cmu-argus-1/Avionics-Mainboard/Mainboard.kicad_pcb

## KiCad design Mainboard.kicad_pcb (2024-07-19)

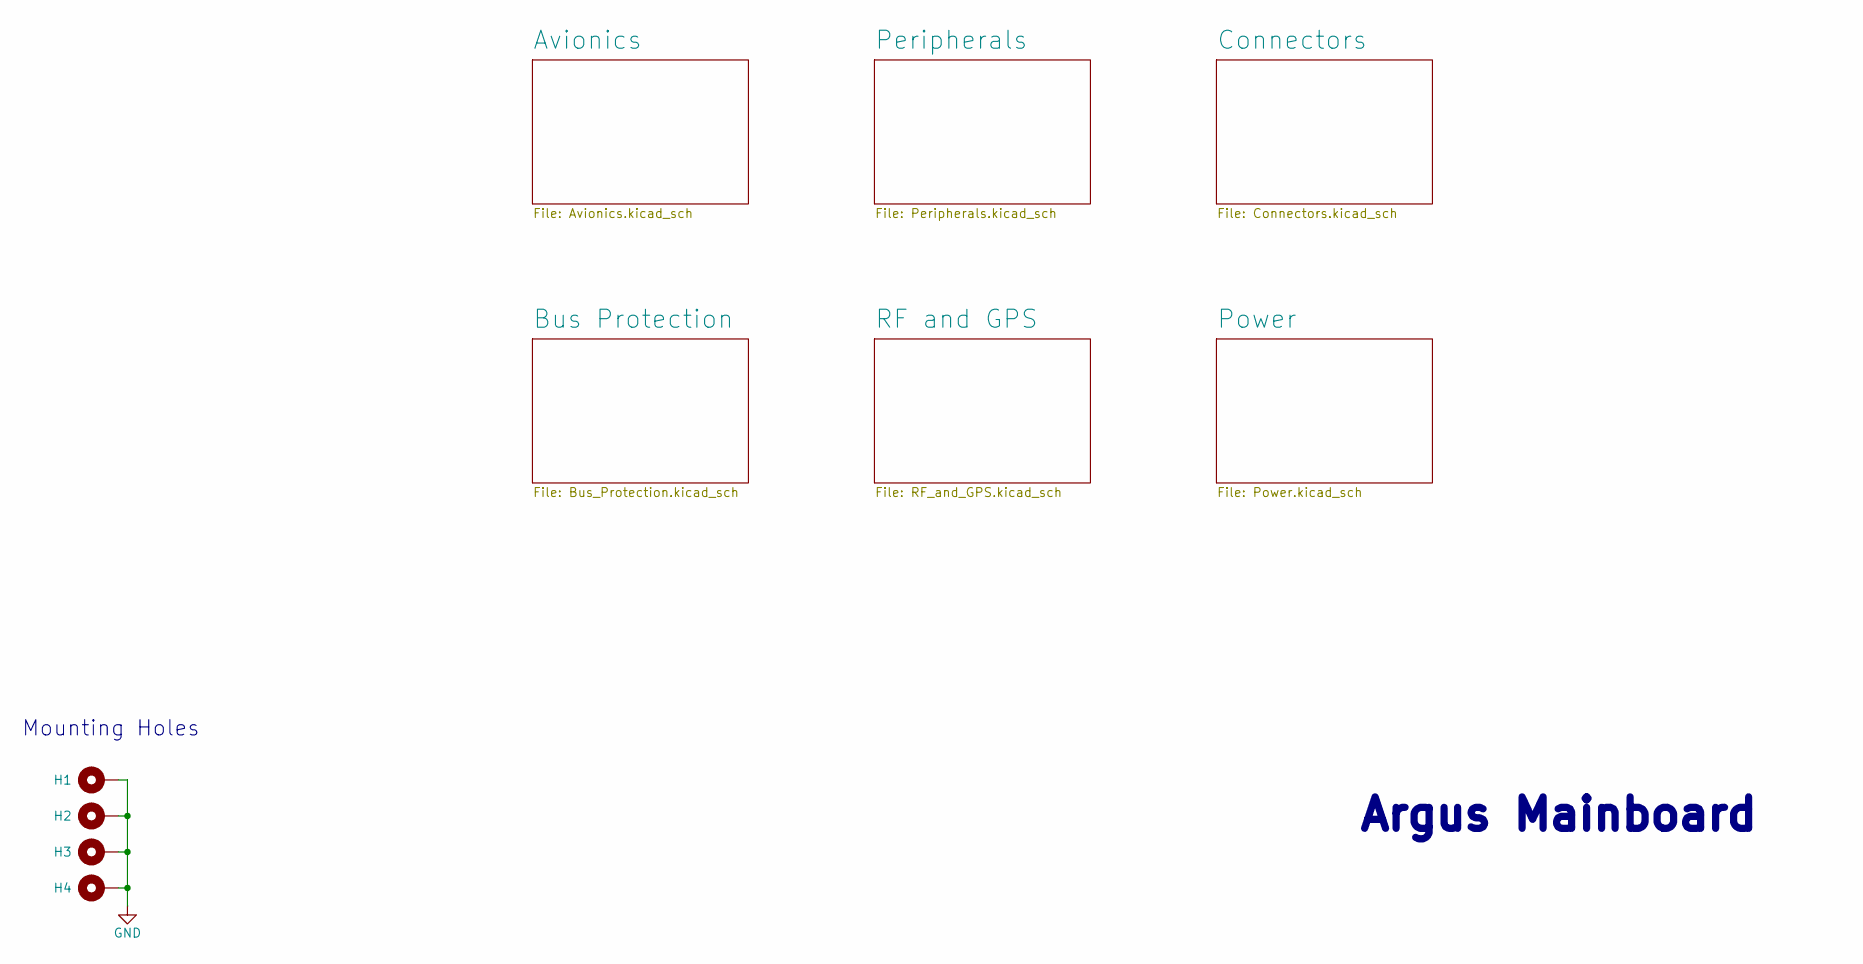
[picture p1: schematic Mainboard.kicad_sch]

Parts:
H1, H2, H3, H4: MountingHole_Pad; MountingHole2

Connections:
GND: H1.1, H2.1, H3.1, H4.1; also elsewhere on the board

Notes on the sheet:
Mounting Holes
Argus Mainboard

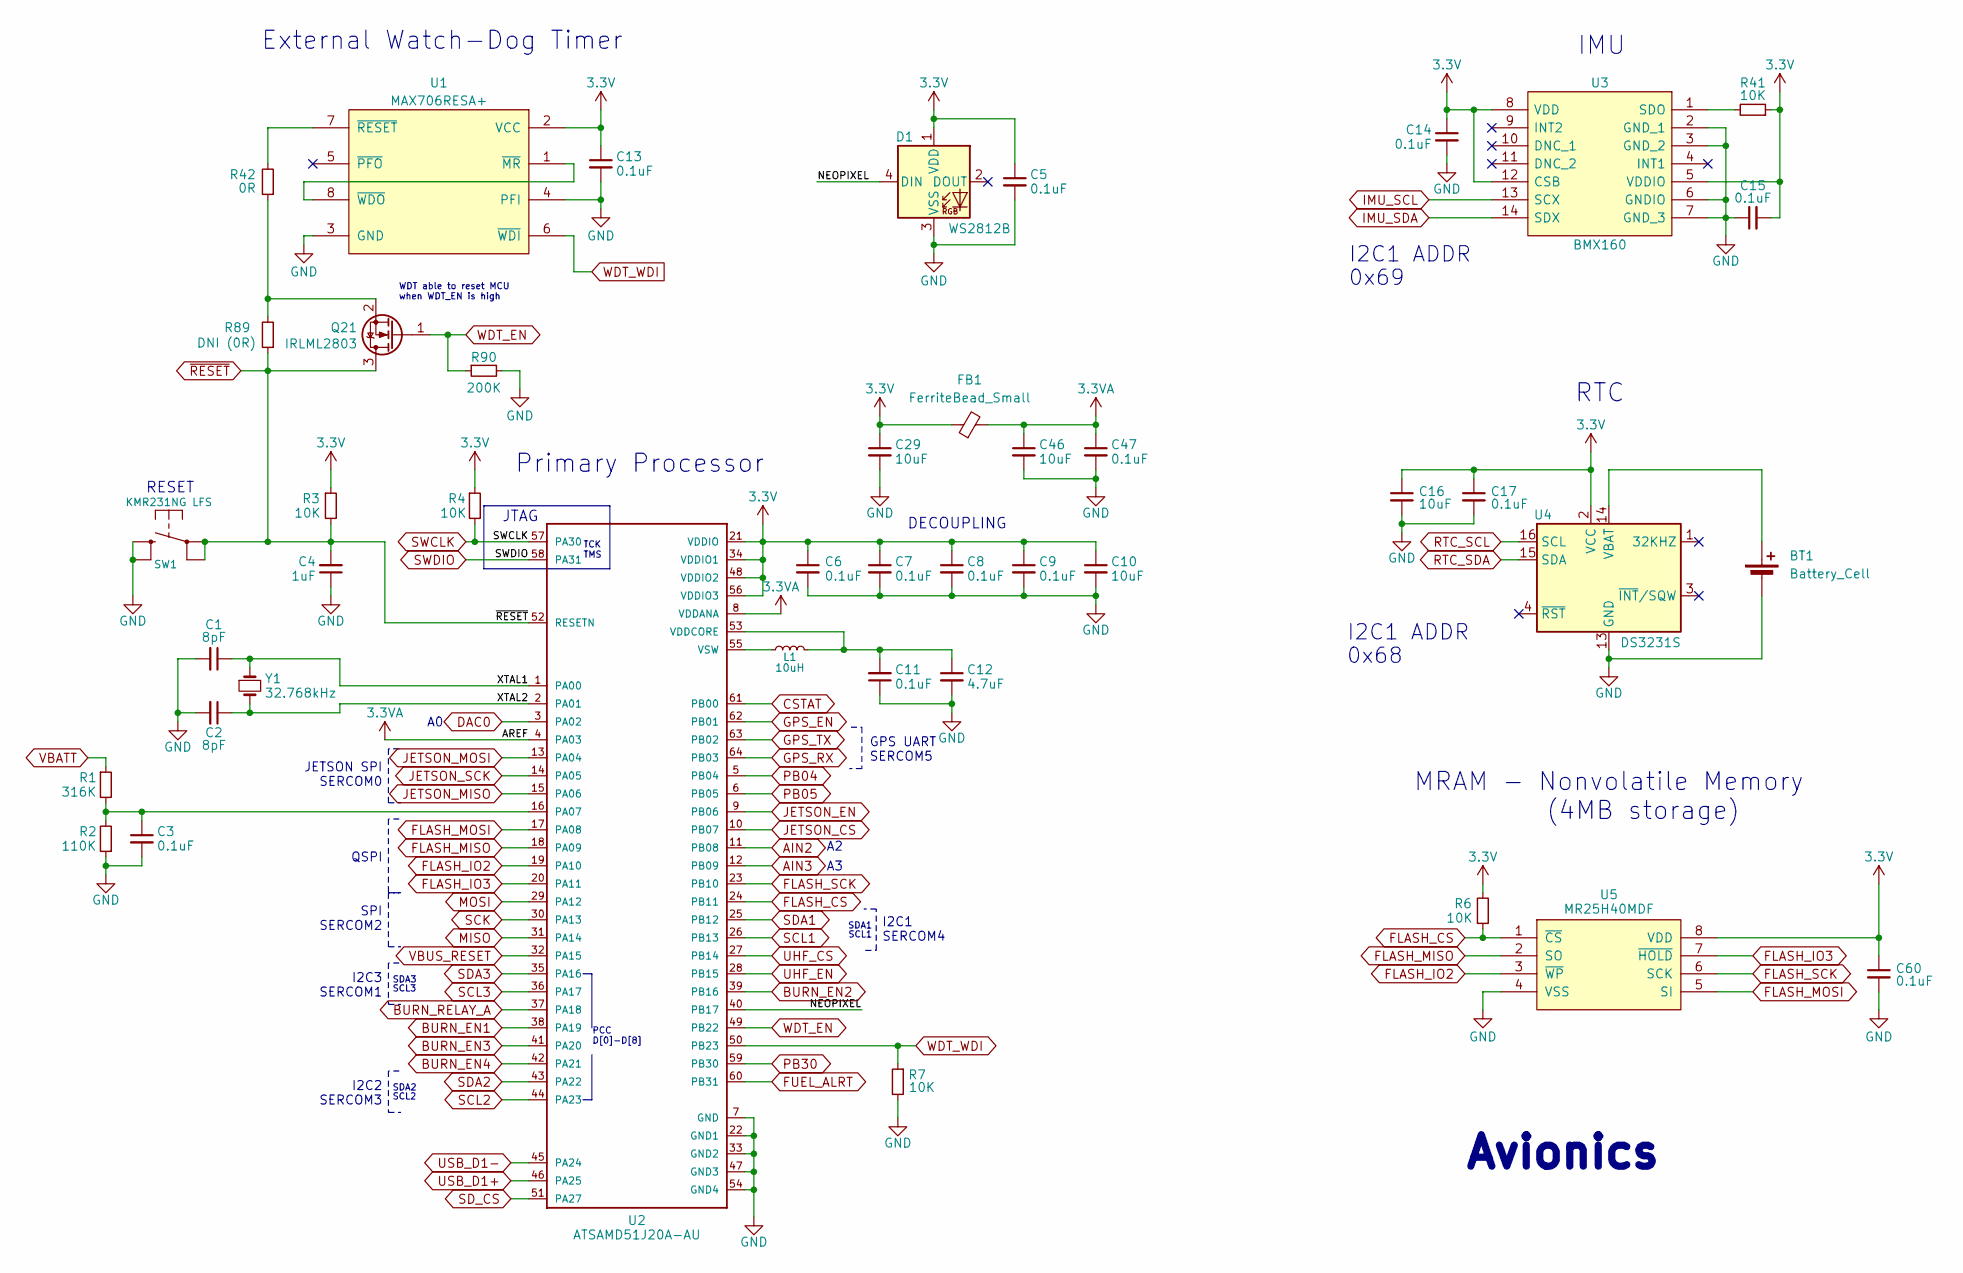
[picture p2: schematic Avionics.kicad_sch, Mainboard]

Parts:
BT1: Battery_Cell; BatteryHolder_LINX_BAT-HLD-012-SMT
C1, C2: 8pF; C_0603_1608Metric
C3, C5, C6, C7, C8, C9, C11, C13, C14, C15, C17, C47, C60: 0.1uF; C_0603_1608Metric
C4: 1uF; C_0603_1608Metric
C10, C16, C29, C46: 10uF; C_0603_1608Metric
C12: 4.7uF; C_0603_1608Metric
D1: WS2812B; LED_WS2812B_PLCC4_5.0x5.0mm_P3.2mm; Manufacturer_Part_Number WS2812B-B
FB1: FerriteBead_Small; L_0603_1608Metric
L1: 10uH; L_0805_2012Metric_Pad1.15x1.40mm_HandSolder; Manufacturer_Part_Number MGFL2012F100MT-LF
Q21: IRLML2803; SOT-23
R1: 316K; R_0603_1608Metric
R2: 110K; R_0603_1608Metric
R3, R4, R6, R7, R41: 10K; R_0603_1608Metric
R42: 0R; R_0603_1608Metric
R89: DNI (0R); R_0603_1608Metric
R90: 200K; R_0603_1608Metric
SW1: KMR231NG LFS; SW_Push_1P1T_NO_CK_KMR2; Manufacturer_Part_Number KMR231NG LFS
U1: MAX706RESA+; SOIC-8_3.9x4.9mm_P1.27mm
U2: ATSAMD51J20A-AU; TQFP-64_10x10mm_P0.5mm; Manufacturer_Part_Number ATSAMD51J20A-AU
U3: BMX160; Bosch_LGA-14_3x2.5mm_P0.5mm; Manufacturer_Part_Number BMX160
U4: DS3231S; SOIC-16W_7.5x10.3mm_P1.27mm
U5: MR25H40MDF; DFN-8-1EP_6x5mm_P1.27mm_EP2x2mm; Manufacturer_Part_Number W25Q80DVSNIG
Y1: 32.768kHz; Crystal_SMD_3215-2Pin_3.2x1.5mm; Manufacturer_Part_Number SC-32S32.768kHz20PPM7pF

Connections:
3.3V: C5.1, C6.1, C7.1, C8.1, C9.1, C10.1, C13.1, C14.1, C15.2, C16.1, C17.1, C29.1, C60.1, D1.1 (VDD), FB1.1, R3.1, R4.1, R6.2, R41.1, U1.2 (VCC), U2.21 (VDDIO), U2.34 (VDDIO1), U2.48 (VDDIO2), U2.56 (VDDIO3), U3.5 (VDDIO), U3.8 (VDD), U3.12 (CSB), U4.2 (VCC), U5.8 (VDD); also elsewhere on the board
3.3VA: C46.1, C47.1, FB1.2, U2.4 (PA03), U2.8 (VDDANA)
/Avionics/NEOPIXEL: D1.4 (DIN), U2.40 (PB17)
/Avionics/XTAL1: C1.1, U2.1 (PA00), Y1.1
/Avionics/XTAL2: C2.1, U2.2 (PA01), Y1.2
AIN2: U2.11 (PB08); also elsewhere on the board
AIN3: U2.12 (PB09)
BURN_EN1: U2.38 (PA19); also elsewhere on the board
BURN_EN2: U2.39 (PB16); also elsewhere on the board
BURN_EN3: U2.41 (PA20); also elsewhere on the board
BURN_EN4: U2.42 (PA21); also elsewhere on the board
BURN_RELAY_A: U2.37 (PA18); also elsewhere on the board
CSTAT: U2.61 (PB00); also elsewhere on the board
DAC0: U2.3 (PA02); also elsewhere on the board
FLASH_CS: R6.1, U2.24 (PB11), U5.1 (~CS)
FLASH_IO2: U2.19 (PA10), U5.3 (~WP)
FLASH_IO3: U2.20 (PA11), U5.7 (~HOLD)
FLASH_MISO: U2.18 (PA09), U5.2 (SO)
FLASH_MOSI: U2.17 (PA08), U5.5 (SI)
FLASH_SCK: U2.23 (PB10), U5.6 (SCK)
FUEL_ALRT: U2.60 (PB31); also elsewhere on the board
GND: BT1.2 (-), C1.2, C2.2, C3.2, C4.1, C5.2, C6.2, C7.2, C8.2, C9.2, C10.2, C11.1, C12.2, C13.2, C14.2, C15.1, C16.2, C17.2, C29.2, C46.2, C47.2, C60.2, D1.3 (VSS), R2.1, R7.2, R90.2, SW1.2 (S), U1.3 (GND), U1.4 (PFI), U2.7 (GND), U2.22 (GND1), U2.33 (GND2), U2.47 (GND3), U2.54 (GND4), U3.2 (GND_1), U3.3 (GND_2), U3.6 (GNDIO), U3.7 (GND_3), U4.5 (GND), U4.6 (GND), U4.7 (GND), U4.8 (GND), U4.9 (GND), U4.10 (GND), U4.11 (GND), U4.12 (GND), U4.13 (GND), U5.4 (VSS), U5.9 (EP); also elsewhere on the board
GPS_EN: U2.62 (PB01); also elsewhere on the board
GPS_RX: U2.64 (PB03); also elsewhere on the board
GPS_TX: U2.63 (PB02); also elsewhere on the board
IMU_SCL: U3.13 (SCX); also elsewhere on the board
IMU_SDA: U3.14 (SDX); also elsewhere on the board
JETSON_CS: U2.10 (PB07); also elsewhere on the board
JETSON_EN: U2.9 (PB06); also elsewhere on the board
JETSON_MISO: U2.15 (PA06); also elsewhere on the board
JETSON_MOSI: U2.13 (PA04); also elsewhere on the board
JETSON_SCK: U2.14 (PA05); also elsewhere on the board
MISO: U2.31 (PA14); also elsewhere on the board
MOSI: U2.29 (PA12); also elsewhere on the board
unnamed: BT1.1 (+), U4.14 (VBAT)
unnamed: Q21.2 (S), R42.1, R89.2
unnamed: U1.1 (~MR), U1.8 (~WDO)
unnamed: R42.2, U1.7 (~RESET)
unnamed: C3.1, R1.2, R2.2, U2.16 (PA07)
unnamed: C11.2, C12.1, L1.1, U2.53 (VDDCORE)
unnamed: L1.2, U2.55 (VSW)
unnamed: R41.2, U3.1 (SDO)
PB04: U2.5 (PB04); also elsewhere on the board
PB05: U2.6 (PB05); also elsewhere on the board
PB30: U2.59 (PB30); also elsewhere on the board
RTC_SCL: U4.16 (SCL); also elsewhere on the board
RTC_SDA: U4.15 (SDA); also elsewhere on the board
SCK: U2.30 (PA13); also elsewhere on the board
SCL1: U2.26 (PB13); also elsewhere on the board
SCL2: U2.44 (PA23); also elsewhere on the board
SCL3: U2.36 (PA17); also elsewhere on the board
SDA1: U2.25 (PB12); also elsewhere on the board
SDA2: U2.43 (PA22); also elsewhere on the board
SDA3: U2.35 (PA16); also elsewhere on the board
SD_CS: U2.51 (PA27); also elsewhere on the board
SWCLK: R4.2, U2.57 (PA30); also elsewhere on the board
SWDIO: U2.58 (PA31); also elsewhere on the board
UHF_CS: U2.27 (PB14); also elsewhere on the board
UHF_EN: U2.28 (PB15); also elsewhere on the board
USB_D1+: U2.46 (PA25); also elsewhere on the board
USB_D1-: U2.45 (PA24); also elsewhere on the board
VBATT: R1.1; also elsewhere on the board
VBUS_RESET: U2.32 (PA15); also elsewhere on the board
WDT_EN: Q21.1 (G), R90.1, U2.49 (PB22)
WDT_WDI: R7.1, U1.6 (~WDI), U2.50 (PB23)
~RESET: C4.2, Q21.3 (D), R3.2, R89.1, SW1.1, U2.52 (RESETN); also elsewhere on the board

Notes on the sheet:
SDA3
RTC
I2C3 SERCOM1
SDA2
Primary Processor
SCL2
I2C1 ADDR
SCL3
0x69
GPS UART SERCOM5
IMU
I2C1 SERCOM4
SPI SERCOM2
RESET
WDT able to reset MCU when WDT_EN is high
JETSON SPI SERCOM0
0x68
Avionics
SDA1
SCL1
TCK TMS
QSPI
External Watch-Dog Timer
I2C2 SERCOM3
PCC D[0]-D[8]
JTAG
DECOUPLING
MRAM - Nonvolatile Memory (4MB storage)

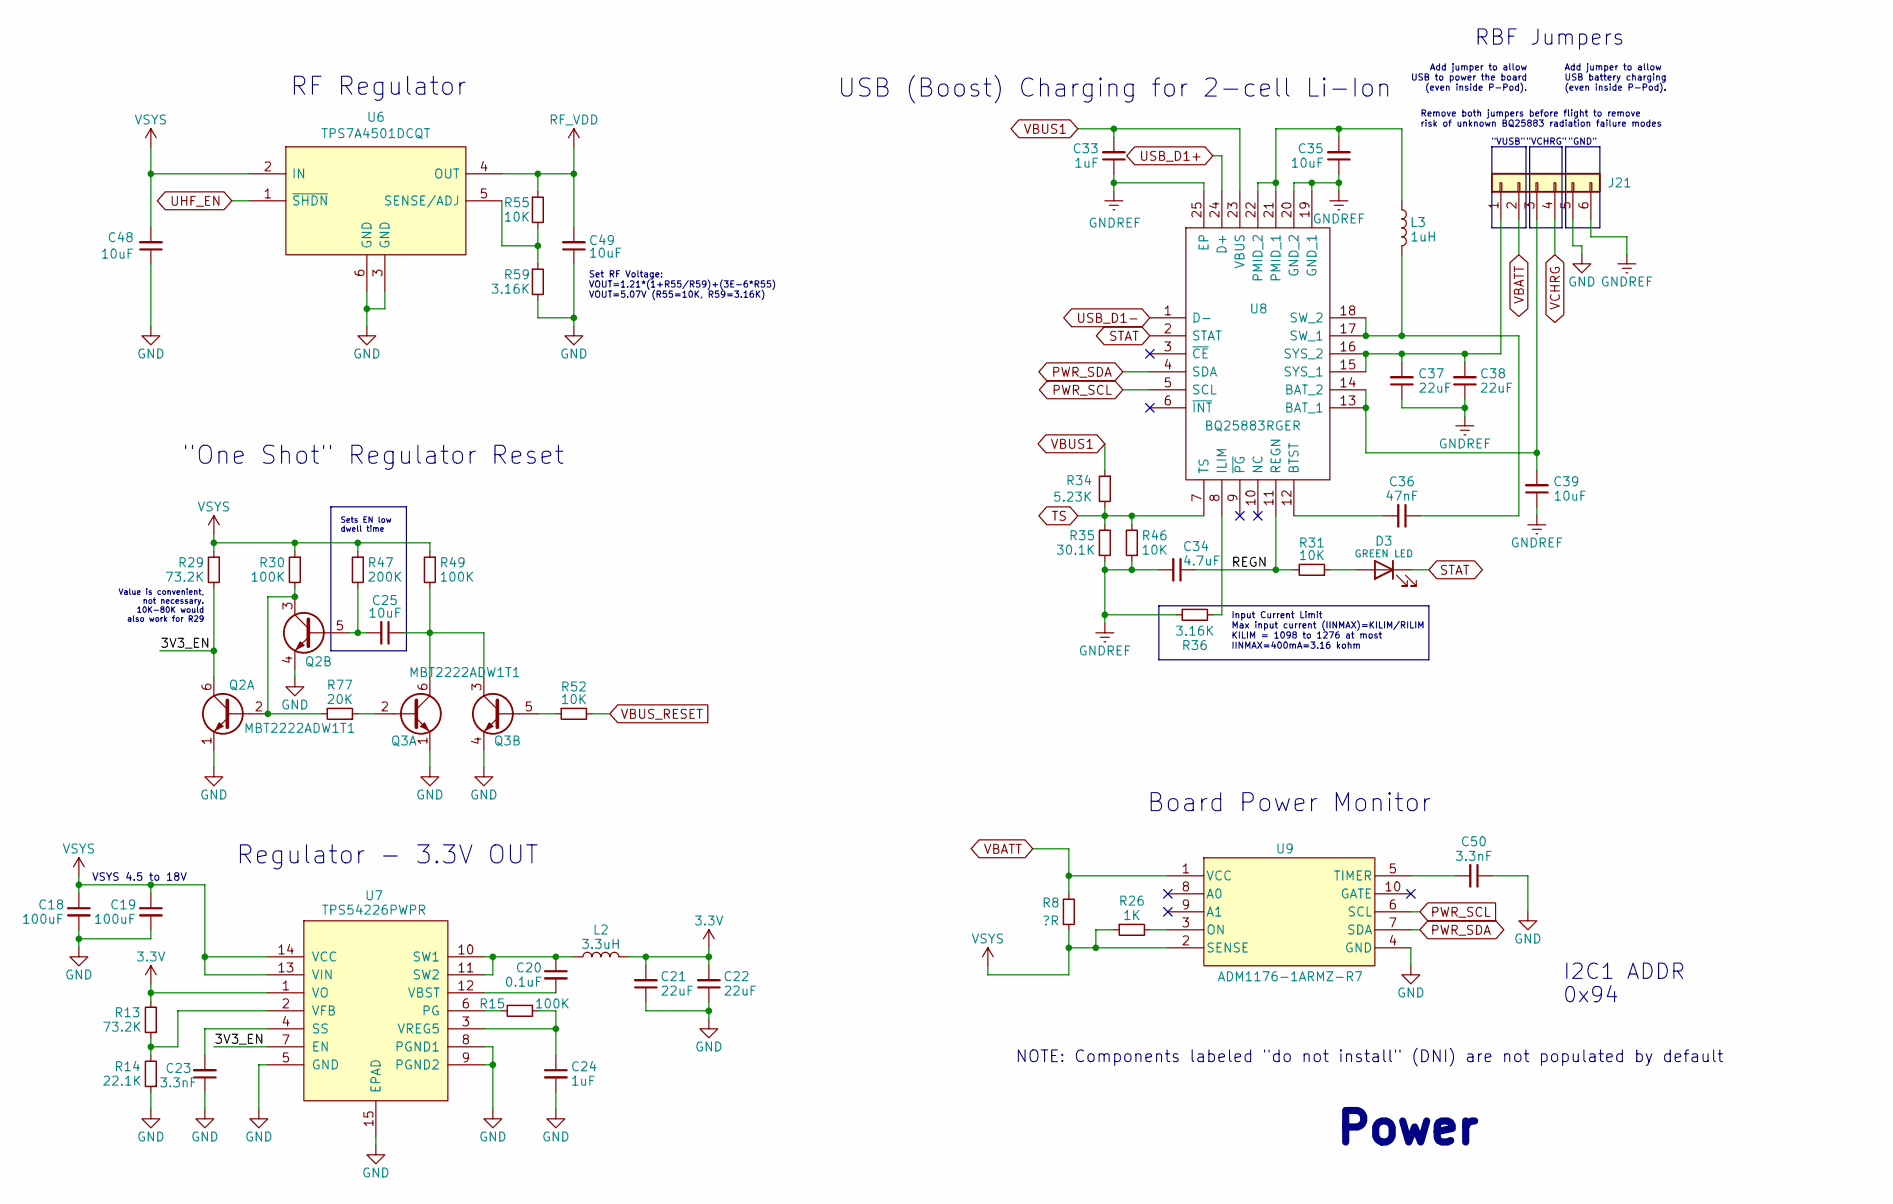
[picture p3: schematic Power.kicad_sch, Mainboard]

Parts:
C18, C19: 100uF; C_0805_2012Metric
C20: 0.1uF; C_0603_1608Metric
C21, C22, C37, C38: 22uF; C_0603_1608Metric
C23, C50: 3.3nF; C_0603_1608Metric
C24, C33: 1uF; C_0603_1608Metric
C25, C35, C39, C48, C49: 10uF; C_0603_1608Metric
C34: 4.7uF; C_0603_1608Metric
C36: 47nF; C_0603_1608Metric
D3: GREEN LED; LED_0603_1608Metric; Manufacturer_Part_Number LTST-C190KGKT
J21: Conn_01x06; PinHeader_1x06_P2.54mm_Vertical
L2: 3.3uH; L_1812_4532Metric; Manufacturer_Part_Number HPC5040NF-3R3MTH
L3: 1uH; L_Wuerth_MAPI-2510; Manufacturer_Part_Number MCS25GD-1R0MMP
Q2, Q3: MBT2222ADW1T1; SOT-363_SC-70-6; Manufacturer_Part_Number MBT2222ADW1T1G
R8: ?R; R_2512_6332Metric
R13, R29: 73.2K; R_0603_1608Metric
R14: 22.1K; R_0603_1608Metric
R15, R30, R49: 100K; R_0603_1608Metric
R26: 1K; R_0603_1608Metric
R31, R46, R52, R55: 10K; R_0603_1608Metric
R34: 5.23K; R_0603_1608Metric
R35: 30.1K; R_0603_1608Metric
R36, R59: 3.16K; R_0603_1608Metric
R47: 200K; R_0603_1608Metric
R77: 20K; R_0603_1608Metric
U6: TPS7A4501DCQT; SOT-223-6; Manufacturer_Part_Number TPS7A4501DCQT
U7: TPS54226PWPR; HTSSOP-14-1EP_4.4x5mm_P0.65mm_EP3.4x5mm_Mask3x3.1mm; Manufacturer_Part_Number TPS54226PWPR
U8: BQ25883RGER; Texas_RGE0024H_VQFN-24-1EP_4x4mm_P0.5mm_EP2.7x2.7mm; Manufacturer_Part_Number BQ25883RGER
U9: ADM1176-1ARMZ-R7; MSOP-10_3x3mm_P0.5mm; Manufacturer_Part_Number ADM1176-1ARMZ-R7

Connections:
3.3V: C21.2, C22.2, L2.2, R13.2, U7.1 (VO); also elsewhere on the board
/Power/3V3_EN: Q2.6 (C1), R29.2, U7.7 (EN)
/Power/REGN: C34.1, R31.2, U8.11 (REGN)
GND: C18.2, C19.2, C21.1, C22.1, C23.1, C24.2, C48.1, C49.1, C50.1, J21.5, Q2.1 (E1), Q2.4 (E2), Q3.1 (E1), Q3.4 (E2), R14.1, R59.2, U6.3 (GND), U6.6 (GND), U7.5 (GND), U7.8 (PGND1), U7.9 (PGND2), U7.15 (EPAD), U9.4 (GND); also elsewhere on the board
GNDREF: C33.1, C34.2, C35.1, C37.1, C38.1, C39.1, J21.6, R35.1, R36.1, R46.1, U8.19 (GND_1), U8.20 (GND_2), U8.25 (EP); also elsewhere on the board
unnamed: D3.2 (A), R31.1
unnamed: C37.2, C38.2, J21.1, U8.15 (SYS_1), U8.16 (SYS_2)
unnamed: C39.2, J21.3, U8.13 (BAT_1), U8.14 (BAT_2)
unnamed: Q2.2 (B1), Q2.3 (C2), R30.2, R77.2
unnamed: C25.2, Q2.5 (B2), R47.2
unnamed: Q3.2 (B1), R77.1
unnamed: C25.1, Q3.3 (C2), Q3.6 (C1), R49.2
unnamed: Q3.5 (B2), R52.1
unnamed: R55.2, R59.1, U6.5 (SENSE/ADJ)
unnamed: R15.2, U7.6 (PG)
unnamed: C23.2, U7.4 (SS)
unnamed: C20.1, L2.1, U7.10 (SW1), U7.11 (SW2)
unnamed: C20.2, U7.12 (VBST)
unnamed: R13.1, R14.2, U7.2 (VFB)
unnamed: C24.1, R15.1, U7.3 (VREG5)
unnamed: C36.2, U8.12 (BTST)
unnamed: R36.2, U8.8 (ILIM)
unnamed: C35.2, L3.1, U8.21 (PMID_1), U8.22 (PMID_2)
unnamed: C36.1, L3.2, U8.17 (SW_1), U8.18 (SW_2)
unnamed: R26.2, U9.3 (ON)
unnamed: C50.2, U9.5 (TIMER)
PWR_SCL: U8.5 (SCL), U9.6 (SCL); also elsewhere on the board
PWR_SDA: U8.4 (SDA), U9.7 (SDA); also elsewhere on the board
RF_VDD: C49.2, R55.1, U6.4 (OUT); also elsewhere on the board
STAT: D3.1 (K), U8.2 (STAT)
TS: R34.2, R35.2, R46.2, U8.7 (TS)
UHF_EN: U6.1 (~SHDN); also elsewhere on the board
USB_D1+: U8.24 (D+); also elsewhere on the board
USB_D1-: U8.1 (D-); also elsewhere on the board
VBATT: J21.2, R8.2, U9.1 (VCC); also elsewhere on the board
VBUS1: C33.2, R34.1, U8.23 (VBUS); also elsewhere on the board
VBUS_RESET: R52.2; also elsewhere on the board
VCHRG: J21.4; also elsewhere on the board
VSYS: C18.1, C19.1, C48.2, R8.1, R26.1, R29.1, R30.1, R47.1, R49.1, U6.2 (IN), U7.13 (VIN), U7.14 (VCC), U9.2 (SENSE)

Notes on the sheet:
"VCHRG"
RF Regulator
Sets EN low dwell time
Remove both jumpers before flight to remove risk of unknown BQ25883 radiation failure modes
RBF Jumpers
Add jumper to allow USB battery charging (even inside P-Pod).
"One Shot" Regulator Reset
I2C1 ADDR
Value is convenient, not necessary. 10K-80K would also work for R29
Board Power Monitor
USB (Boost) Charging for 2-cell Li-Ion
"GND"
VSYS 4.5 to 18V
Input Current Limit Max input current (IINMAX)=KILIM/RILIM KILIM = 1098 to 1276 at most IINMAX=400mA=3.16 kohm
"VUSB"
Power
Set RF Voltage: VOUT=1.21*(1+R55/R59)+(3E-6*R55) VOUT=5.07V (R55=10K, R59=3.16K)
Regulator - 3.3V OUT
Add jumper to allow USB to power the board (even inside P-Pod).
NOTE: Components labeled "do not install" (DNI) are not populated by default
0x94

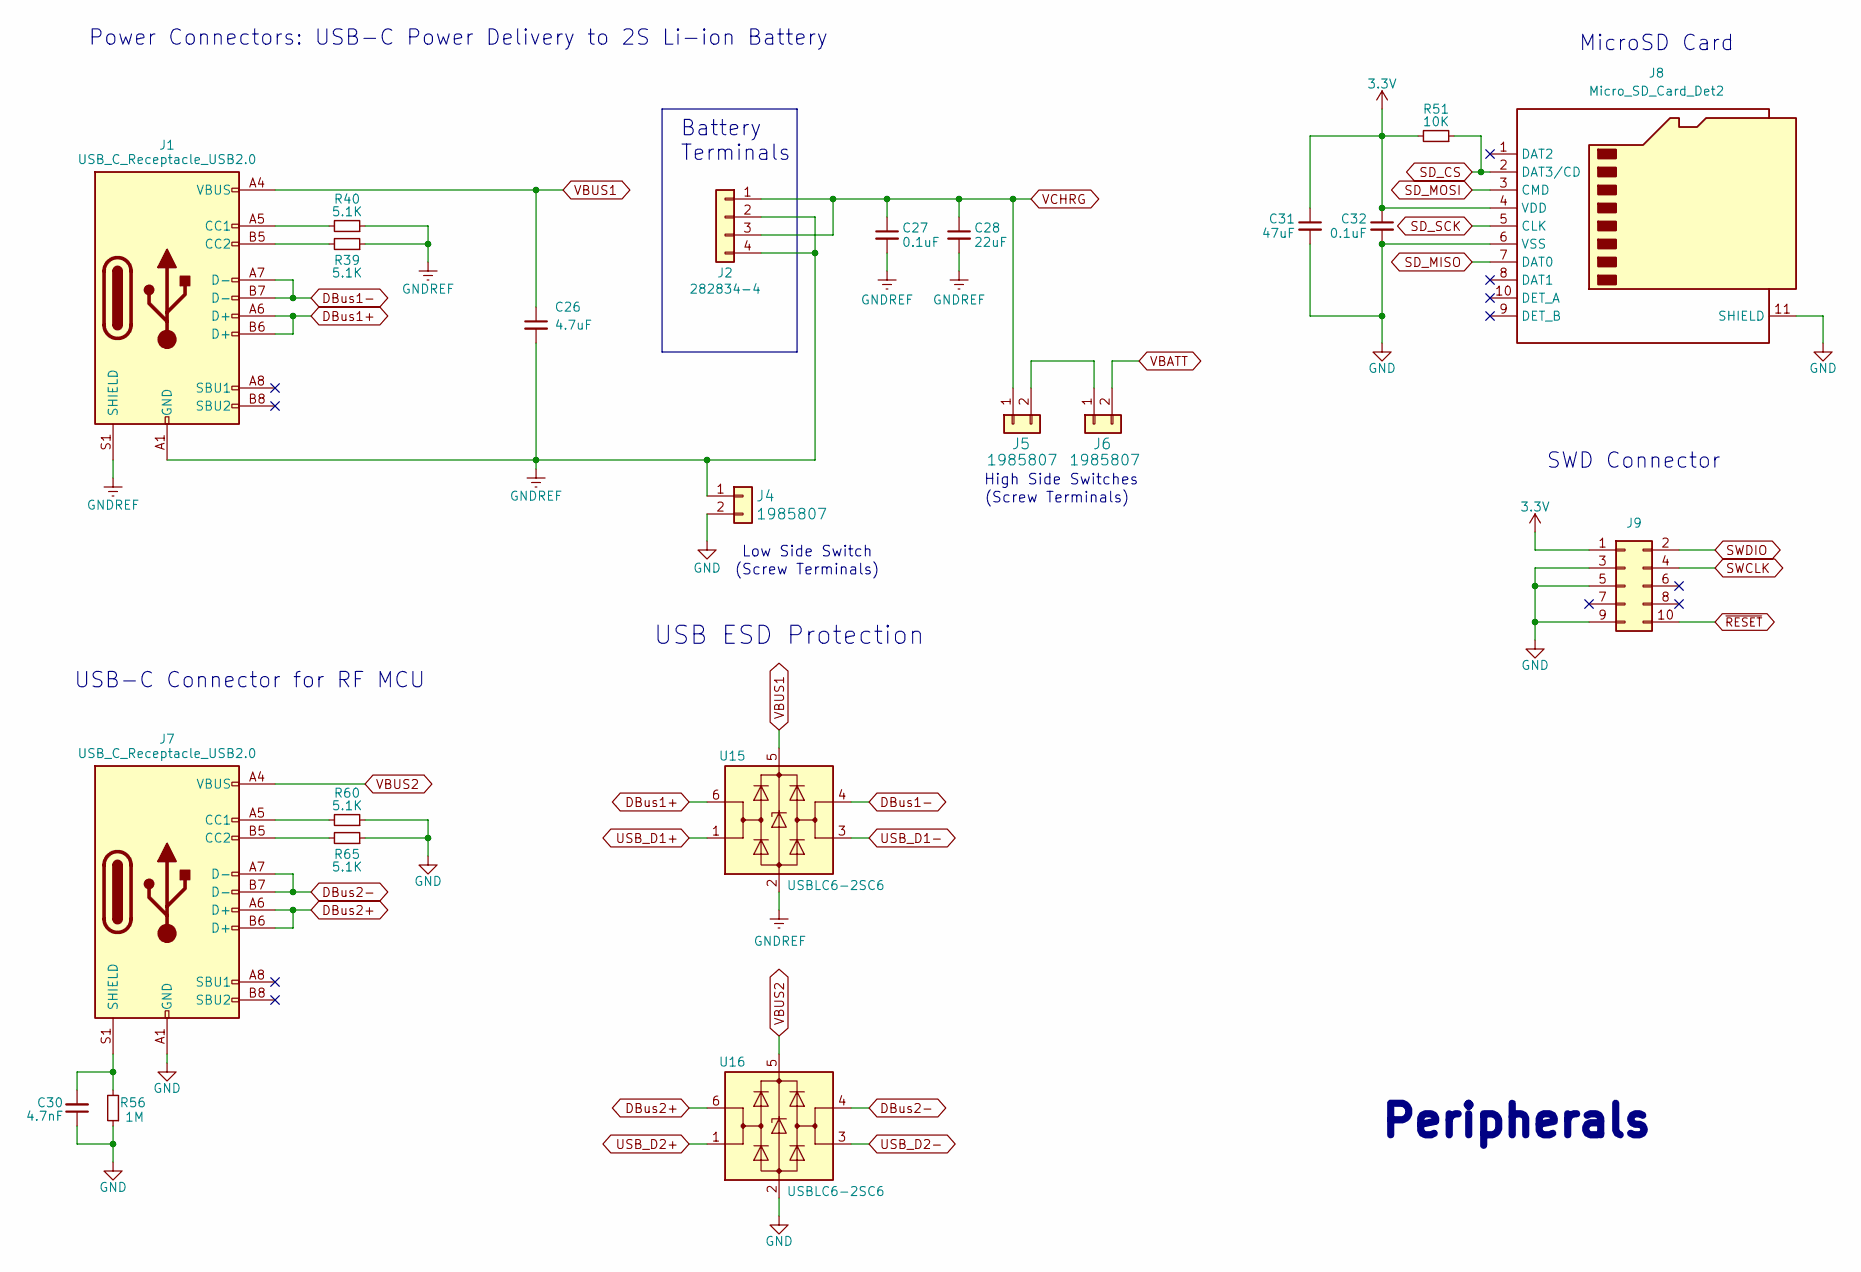
[picture p4: schematic Peripherals.kicad_sch, Mainboard]

Parts:
C26: 4.7uF; C_0603_1608Metric
C27, C32: 0.1uF; C_0603_1608Metric
C28: 22uF; C_0603_1608Metric
C30: 4.7nF; C_0603_1608Metric
C31: 47uF; C_0805_2012Metric
J1, J7: USB_C_Receptacle_USB2.0; USB_C_Receptacle_HRO_TYPE-C-31-M-12; Manufacturer_Part_Number U262-161N-4BVC11
J2: 282834-4; TE_282834-4
J4, J5, J6: 1985807; PHOENIX_1985807; Manufacturer_Part_Number 1985807
J8: Micro_SD_Card_Det2; microSD_HC_Molex_104031-0811
J9: Conn_02x05_Odd_Even; PinHeader_2x05_P1.27mm_Vertical_SMD
R39, R40, R60, R65: 5.1K; R_0603_1608Metric
R51: 10K; R_0603_1608Metric
R56: 1M; R_0603_1608Metric
U15, U16: USBLC6-2SC6; SOT-23-6

Connections:
3.3V: C31.1, C32.1, J8.4 (VDD), J9.1, R51.2; also elsewhere on the board
DBus1+: J1.A6 (D+), J1.B6 (D+), U15.6 (I/O1)
DBus1-: J1.A7 (D-), J1.B7 (D-), U15.4 (I/O2)
DBus2+: J7.A6 (D+), J7.B6 (D+), U16.6 (I/O1)
DBus2-: J7.A7 (D-), J7.B7 (D-), U16.4 (I/O2)
GND: C30.1, C31.2, C32.2, J4.2, J7.A1 (GND), J7.A12 (GND), J7.B1 (GND), J7.B12 (GND), J8.6 (VSS), J8.11 (SHIELD), J9.3, J9.5, J9.9, R56.1, R60.1, R65.1, U16.2 (GND); also elsewhere on the board
GNDREF: C26.2, C27.2, C28.2, J1.A1 (GND), J1.A12 (GND), J1.B1 (GND), J1.B12 (GND), J1.S1 (SHIELD), J2.2, J2.4, J4.1, R39.1, R40.1, U15.2 (GND); also elsewhere on the board
unnamed: J1.A5 (CC1), R40.2
unnamed: J1.B5 (CC2), R39.2
unnamed: J5.2, J6.1
unnamed: J7.A5 (CC1), R60.2
unnamed: J7.B5 (CC2), R65.2
unnamed: C30.2, J7.S1 (SHIELD), R56.2
SD_CS: J8.2 (DAT3/CD), R51.1; also elsewhere on the board
SD_MISO: J8.7 (DAT0); also elsewhere on the board
SD_MOSI: J8.3 (CMD); also elsewhere on the board
SD_SCK: J8.5 (CLK); also elsewhere on the board
SWCLK: J9.4; also elsewhere on the board
SWDIO: J9.2; also elsewhere on the board
USB_D1+: U15.1 (I/O1); also elsewhere on the board
USB_D1-: U15.3 (I/O2); also elsewhere on the board
USB_D2+: U16.1 (I/O1); also elsewhere on the board
USB_D2-: U16.3 (I/O2); also elsewhere on the board
VBATT: J6.2; also elsewhere on the board
VBUS1: C26.1, J1.A4 (VBUS), J1.A9 (VBUS), J1.B4 (VBUS), J1.B9 (VBUS), U15.5 (VBUS); also elsewhere on the board
VBUS2: J7.A4 (VBUS), J7.A9 (VBUS), J7.B4 (VBUS), J7.B9 (VBUS), U16.5 (VBUS)
VCHRG: C27.1, C28.1, J2.1, J2.3, J5.1; also elsewhere on the board
~RESET: J9.10; also elsewhere on the board

Notes on the sheet:
Power Connectors: USB-C Power Delivery to 2S Li-ion Battery
(Screw Terminals)
SWD Connector
MicroSD Card
Low Side Switch
Peripherals
USB ESD Protection
Battery Terminals
USB-C Connector for RF MCU
High Side Switches

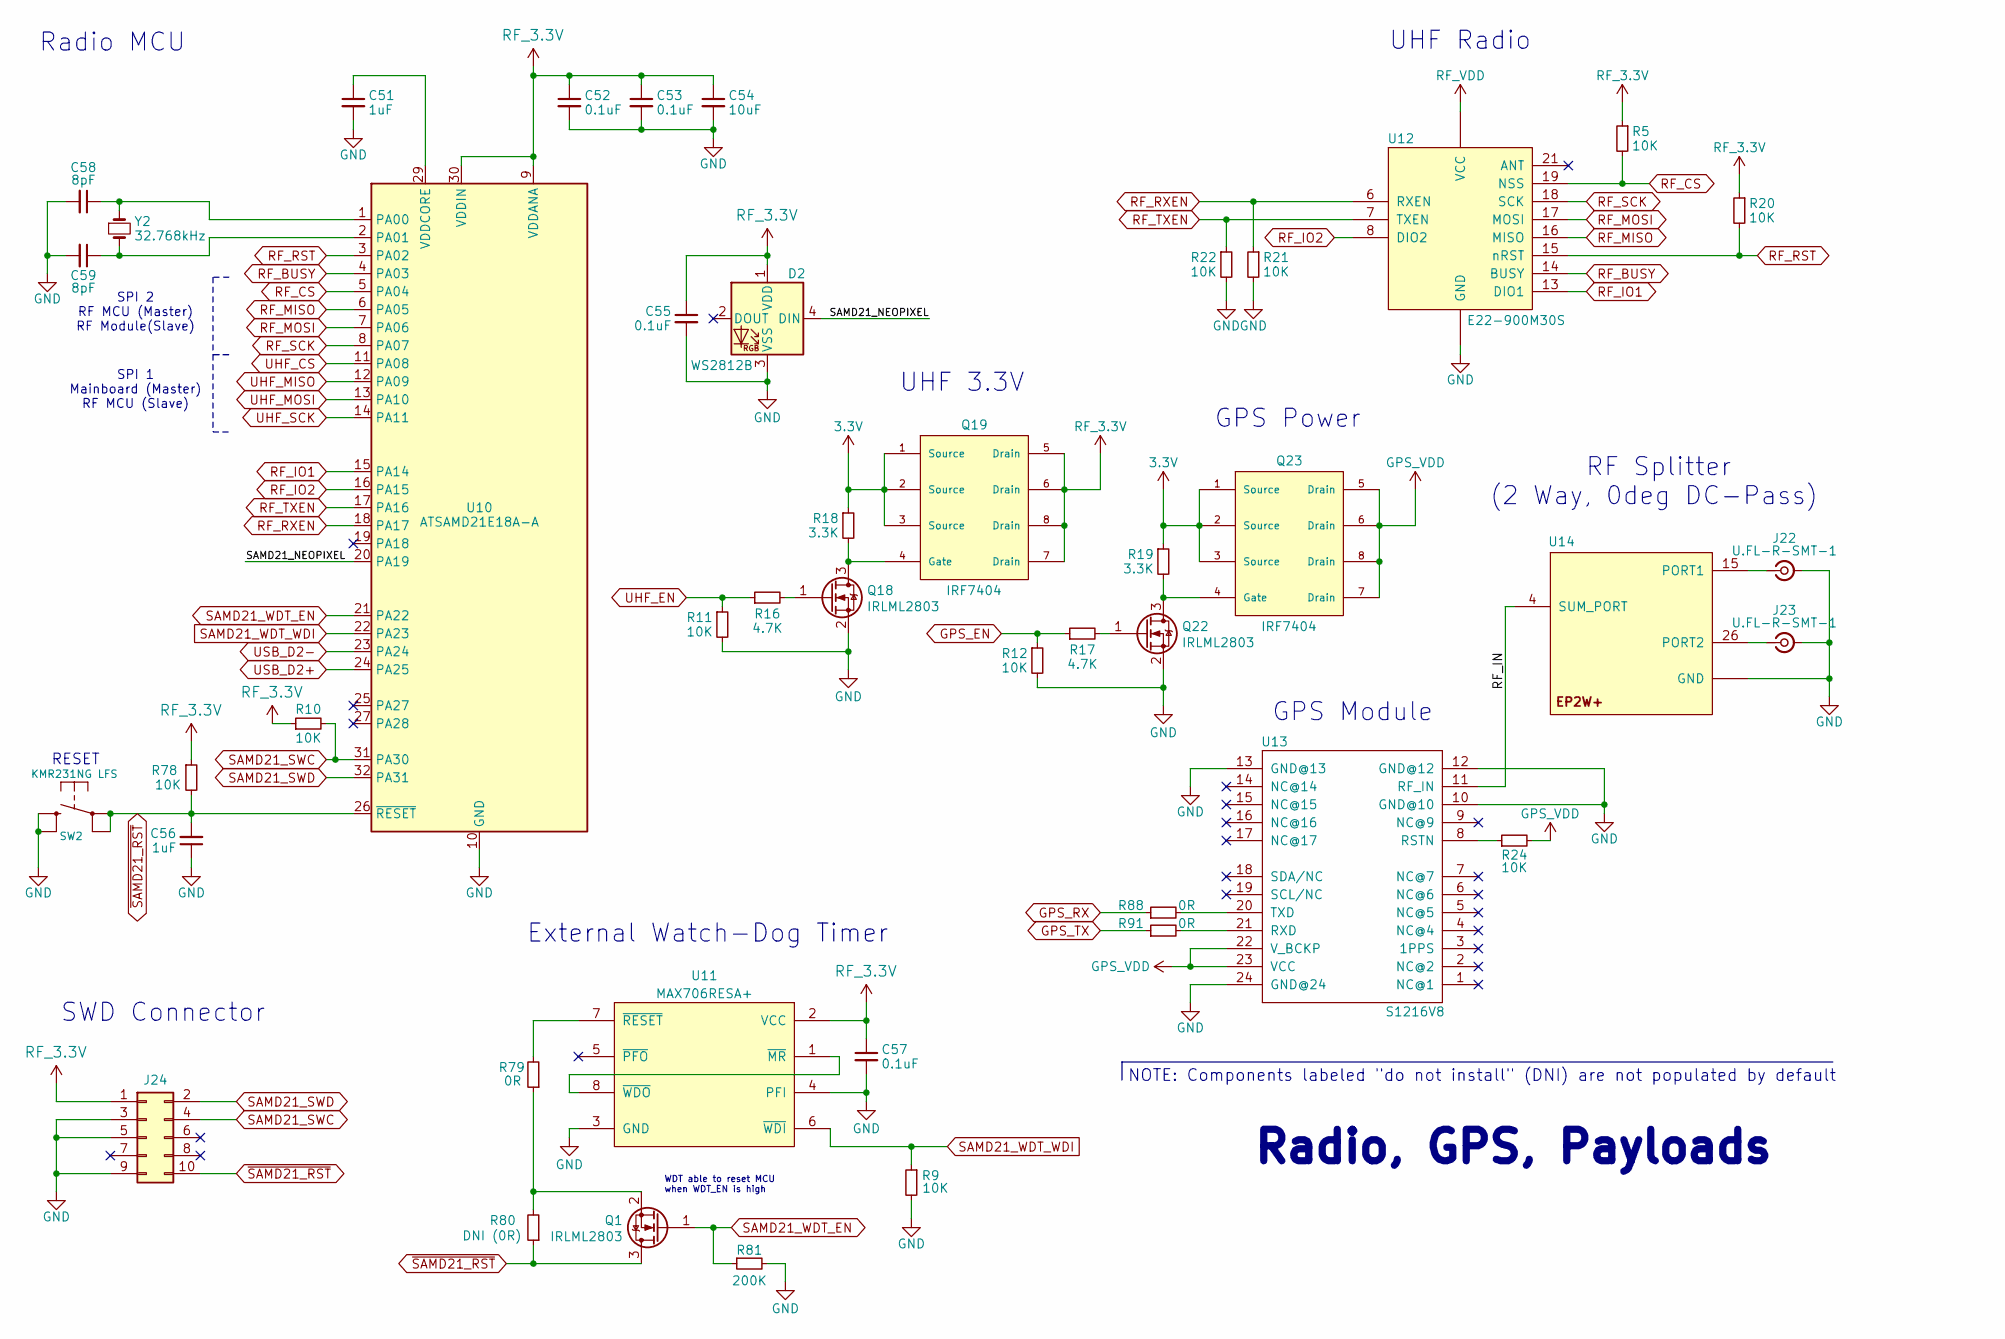
[picture p5: schematic RF_and_GPS.kicad_sch, Mainboard]

Parts:
C51, C56: 1uF; C_0603_1608Metric
C52, C53, C55, C57: 0.1uF; C_0603_1608Metric
C54: 10uF; C_0603_1608Metric
C58, C59: 8pF; C_0603_1608Metric
D2: WS2812B; LED_WS2812B_PLCC4_5.0x5.0mm_P3.2mm; Manufacturer_Part_Number WS2812B-B
J22, J23: U.FL-R-SMT-1; U.FL_Hirose_U.FL-R-SMT-1_Vertical
J24: Conn_02x05_Odd_Even; PinHeader_2x05_P1.27mm_Vertical_SMD
Q1, Q18, Q22: IRLML2803; SOT-23
Q19, Q23: IRF7404; SOIC-8_3.9x4.9mm_P1.27mm; Manufacturer_Part_Number NDS8434
R5, R9, R10, R11, R12, R20, R21, R22, R24, R78: 10K; R_0603_1608Metric
R16, R17: 4.7K; R_0603_1608Metric
R18, R19: 3.3K; R_0603_1608Metric
R79, R88, R91: 0R; R_0603_1608Metric
R80: DNI (0R); R_0603_1608Metric
R81: 200K; R_0603_1608Metric
SW2: KMR231NG LFS; SW_Push_1P1T_NO_CK_KMR2; Manufacturer_Part_Number KMR231NG LFS
U10: ATSAMD21E18A-A; TQFP-32_7x7mm_P0.8mm
U11: MAX706RESA+; SOIC-8_3.9x4.9mm_P1.27mm
U12: E22-900M30S; XCVR_E22-900M30S; Manufacturer_Part_Number RFM98PW
U13: S1216V8; S1216_24PIN_PACKAGE
U14: EP2W+; Manufacturer_Part_Number EP2W+
Y2: 32.768kHz; Crystal_SMD_3215-2Pin_3.2x1.5mm; Manufacturer_Part_Number SC-32S32.768kHz20PPM7pF

Connections:
3.3V: Q19.1 (Source), Q19.2 (Source), Q19.3 (Source), Q23.1 (Source), Q23.2 (Source), Q23.3 (Source), R18.1, R19.1; also elsewhere on the board
/RF and GPS/RF_IN: U13.11 (RF_IN), U14.4 (SUM_PORT)
/RF and GPS/SAMD21_NEOPIXEL: D2.4 (DIN), U10.20 (PA19)
GND: C51.2, C52.2, C53.2, C54.2, C55.2, C56.1, C57.2, C58.2, C59.2, D2.3 (VSS), J22.2 (Ext), J23.2 (Ext), J24.3, J24.5, J24.9, Q18.2 (S), Q22.2 (S), R9.2, R11.2, R12.2, R21.2, R22.2, R81.2, SW2.2 (S), U10.10 (GND), U10.28 (GND), U11.3 (GND), U11.4 (PFI), U12.1 (GND), U12.2 (GND), U12.3 (GND), U12.4 (GND), U12.5 (GND), U12.11 (GND), U12.12 (GND), U12.20 (GND), U12.22 (GND), U13.10 (GND@10), U13.12 (GND@12), U13.13 (GND@13), U13.24 (GND@24), U14.1 (GND), U14.2 (GND), U14.3 (GND), U14.5 (GND), U14.6 (GND), U14.7 (GND), U14.8 (GND), U14.9 (GND), U14.10 (GND), U14.11 (GND), U14.12 (GND), U14.13 (GND), U14.14 (GND), U14.16 (GND), U14.17 (GND), U14.18 (GND), U14.19 (GND), U14.20 (GND), U14.21 (GND), U14.22 (GND), U14.23 (GND), U14.24 (GND), U14.25 (GND), U14.27 (GND), U14.28 (GND), U14.29 (GND), U14.30 (GND), U14.31 (GND), U14.32 (GND), U14.EP (GND); also elsewhere on the board
GPS_EN: R12.1, R17.1; also elsewhere on the board
GPS_RX: R88.1; also elsewhere on the board
GPS_TX: R91.1; also elsewhere on the board
GPS_VDD: Q23.5 (Drain), Q23.6 (Drain), Q23.7 (Drain), Q23.8 (Drain), R24.2, U13.22 (V_BCKP), U13.23 (VCC)
unnamed: J22.1 (In), U14.15 (PORT1)
unnamed: J23.1 (In), U14.26 (PORT2)
unnamed: Q1.2 (S), R79.1, R80.2
unnamed: Q18.3 (D), Q19.4 (Gate), R18.2
unnamed: Q18.1 (G), R16.2
unnamed: Q22.3 (D), Q23.4 (Gate), R19.2
unnamed: Q22.1 (G), R17.2
unnamed: C58.1, U10.1 (PA00), Y2.1
unnamed: C59.1, U10.2 (PA01), Y2.2
unnamed: C51.1, U10.29 (VDDCORE)
unnamed: U11.1 (~MR), U11.8 (~WDO)
unnamed: R79.2, U11.7 (~RESET)
unnamed: R24.1, U13.8 (RSTN)
unnamed: R91.2, U13.21 (RXD)
unnamed: R88.2, U13.20 (TXD)
RF_3.3V: C52.1, C53.1, C54.1, C55.1, C57.1, D2.1 (VDD), J24.1, Q19.5 (Drain), Q19.6 (Drain), Q19.7 (Drain), Q19.8 (Drain), R5.1, R10.1, R20.1, R78.1, U10.9 (VDDANA), U10.30 (VDDIN), U11.2 (VCC)
RF_BUSY: U10.4 (PA03), U12.14 (BUSY)
RF_CS: R5.2, U10.5 (PA04), U12.19 (NSS)
RF_IO1: U10.15 (PA14), U12.13 (DIO1)
RF_IO2: U10.16 (PA15), U12.8 (DIO2)
RF_MISO: U10.6 (PA05), U12.16 (MISO)
RF_MOSI: U10.7 (PA06), U12.17 (MOSI)
RF_RST: R20.2, U10.3 (PA02), U12.15 (nRST)
RF_RXEN: R21.1, U10.18 (PA17), U12.6 (RXEN)
RF_SCK: U10.8 (PA07), U12.18 (SCK)
RF_TXEN: R22.1, U10.17 (PA16), U12.7 (TXEN)
RF_VDD: U12.9 (VCC), U12.10 (VCC); also elsewhere on the board
SAMD21_SWC: J24.4, R10.2, U10.31 (PA30)
SAMD21_SWD: J24.2, U10.32 (PA31)
SAMD21_WDT_EN: Q1.1 (G), R81.1, U10.21 (PA22)
SAMD21_WDT_WDI: R9.1, U10.22 (PA23), U11.6 (~WDI)
UHF_CS: U10.11 (PA08); also elsewhere on the board
UHF_EN: R11.1, R16.1; also elsewhere on the board
UHF_MISO: U10.12 (PA09); also elsewhere on the board
UHF_MOSI: U10.13 (PA10); also elsewhere on the board
UHF_SCK: U10.14 (PA11); also elsewhere on the board
USB_D2+: U10.24 (PA25); also elsewhere on the board
USB_D2-: U10.23 (PA24); also elsewhere on the board
~SAMD21_RST: C56.2, J24.10, Q1.3 (D), R78.2, R80.1, SW2.1, U10.26 (~RESET)

Notes on the sheet:
Radio, GPS, Payloads
External Watch-Dog Timer
SPI 2 RF MCU (Master) RF Module(Slave)
SWD Connector
SPI 1 Mainboard (Master) RF MCU (Slave)
RF Splitter (2 Way, 0deg DC-Pass)
UHF 3.3V
NOTE: Components labeled "do not install" (DNI) are not populated by default
Radio MCU
GPS Power
GPS Module
RESET
UHF Radio
WDT able to reset MCU when WDT_EN is high
