cmu-argus-1/Avionics-Mainboard/Mainboard.kicad_pcb

## KiCad design Mainboard.kicad_pcb (continued)

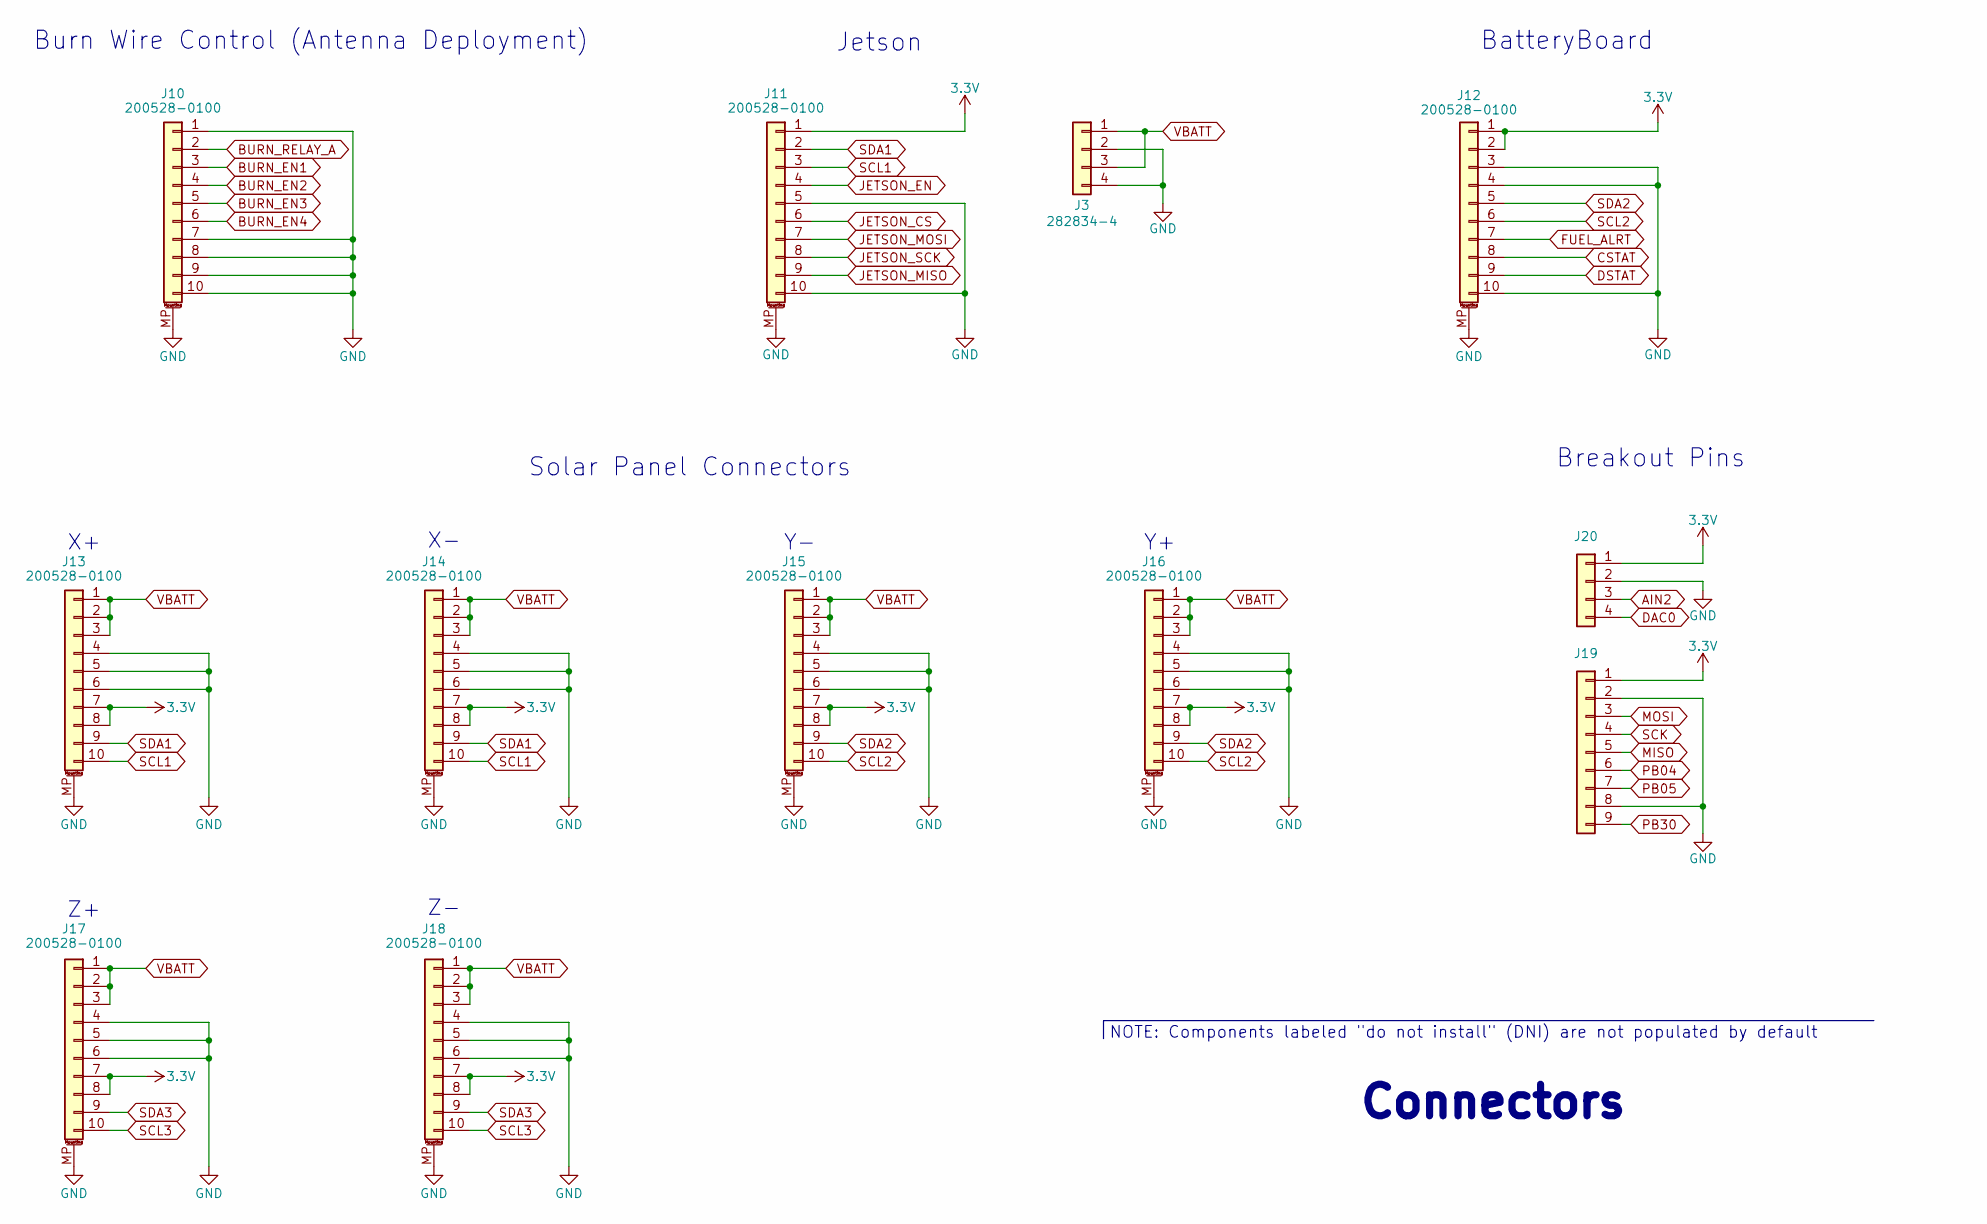
[picture p6: schematic Connectors.kicad_sch, Mainboard]

Parts:
J3: 282834-4; TE_282834-4
J10, J11, J12, J13, J14, J15, J16, J17, J18: 200528-0100; Molex_200528-0100_1x10-1MP_P1.00mm_Horizontal
J19: Conn_01x09; PinHeader_1x09_P2.54mm_Vertical
J20: Conn_01x04; PinHeader_1x04_P2.54mm_Vertical

Connections:
3.3V: J11.1, J12.1, J12.2, J13.7, J13.8, J14.7, J14.8, J15.7, J15.8, J16.7, J16.8, J17.7, J17.8, J18.7, J18.8, J19.1, J20.1; also elsewhere on the board
AIN2: J20.3; also elsewhere on the board
BURN_EN1: J10.3; also elsewhere on the board
BURN_EN2: J10.4; also elsewhere on the board
BURN_EN3: J10.5; also elsewhere on the board
BURN_EN4: J10.6; also elsewhere on the board
BURN_RELAY_A: J10.2; also elsewhere on the board
CSTAT: J12.8; also elsewhere on the board
DAC0: J20.4; also elsewhere on the board
DSTAT: J12.9
FUEL_ALRT: J12.7; also elsewhere on the board
GND: J3.2, J3.4, J10.1, J10.7, J10.8, J10.9, J10.10, J10.MP (MountPin), J11.5, J11.10, J11.MP (MountPin), J12.3, J12.4, J12.10, J12.MP (MountPin), J13.4, J13.5, J13.6, J13.MP (MountPin), J14.4, J14.5, J14.6, J14.MP (MountPin), J15.4, J15.5, J15.6, J15.MP (MountPin), J16.4, J16.5, J16.6, J16.MP (MountPin), J17.4, J17.5, J17.6, J17.MP (MountPin), J18.4, J18.5, J18.6, J18.MP (MountPin), J19.2, J19.8, J20.2; also elsewhere on the board
JETSON_CS: J11.6; also elsewhere on the board
JETSON_EN: J11.4; also elsewhere on the board
JETSON_MISO: J11.9; also elsewhere on the board
JETSON_MOSI: J11.7; also elsewhere on the board
JETSON_SCK: J11.8; also elsewhere on the board
MISO: J19.5; also elsewhere on the board
MOSI: J19.3; also elsewhere on the board
PB04: J19.6; also elsewhere on the board
PB05: J19.7; also elsewhere on the board
PB30: J19.9; also elsewhere on the board
SCK: J19.4; also elsewhere on the board
SCL1: J11.3, J13.10, J14.10; also elsewhere on the board
SCL2: J12.6, J15.10, J16.10; also elsewhere on the board
SCL3: J17.10, J18.10; also elsewhere on the board
SDA1: J11.2, J13.9, J14.9; also elsewhere on the board
SDA2: J12.5, J15.9, J16.9; also elsewhere on the board
SDA3: J17.9, J18.9; also elsewhere on the board
VBATT: J3.1, J3.3, J13.1, J13.2, J13.3, J14.1, J14.2, J14.3, J15.1, J15.2, J15.3, J16.1, J16.2, J16.3, J17.1, J17.2, J17.3, J18.1, J18.2, J18.3; also elsewhere on the board

Notes on the sheet:
BatteryBoard
Burn Wire Control (Antenna Deployment)
Connectors
NOTE: Components labeled "do not install" (DNI) are not populated by default
Solar Panel Connectors
Breakout Pins
Jetson

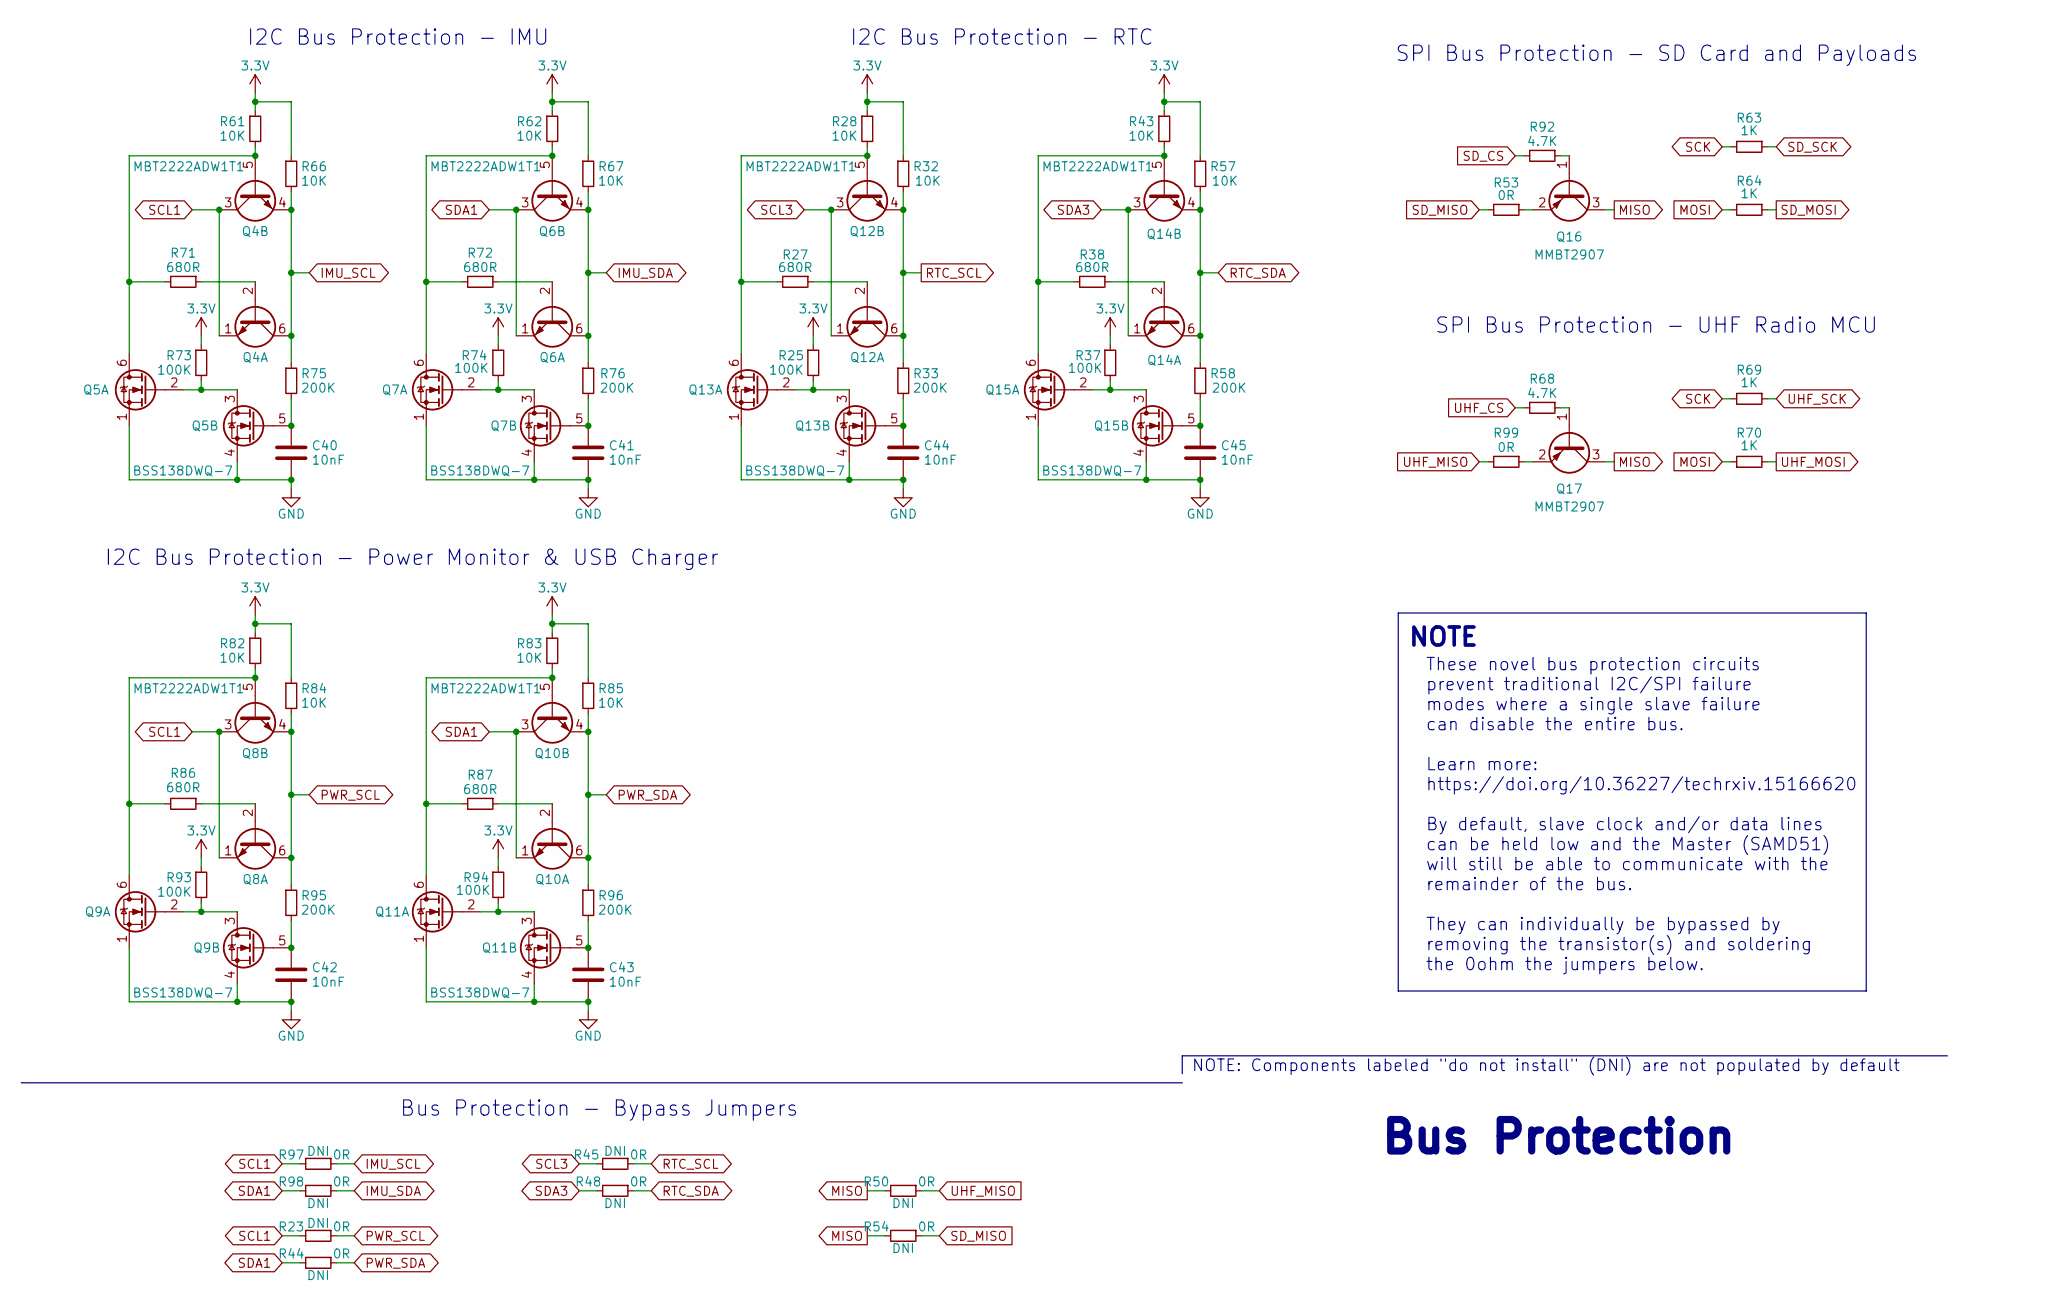
[picture p7: schematic Bus_Protection.kicad_sch, Mainboard]

Parts:
C40, C41, C42, C43, C44, C45: 10nF; C_0603_1608Metric
Q4, Q6, Q8, Q10, Q12, Q14: MBT2222ADW1T1; SOT-363_SC-70-6; Manufacturer_Part_Number MBT2222ADW1T1G
Q5, Q7, Q9, Q11, Q13, Q15: BSS138DWQ-7; SOT-363_SC-70-6; Manufacturer_Part_Number BSS138DWQ-7
Q16, Q17: MMBT2907; SOT-23
R23, R44, R45, R48, R50, R53, R54, R97, R98, R99: 0R; R_0603_1608Metric
R25, R37, R73, R74, R93, R94: 100K; R_0603_1608Metric
R27, R38, R71, R72, R86, R87: 680R; R_0603_1608Metric
R28, R32, R43, R57, R61, R62, R66, R67, R82, R83, R84, R85: 10K; R_0603_1608Metric
R33, R58, R75, R76, R95, R96: 200K; R_0603_1608Metric
R63, R64, R69, R70: 1K; R_0603_1608Metric
R68, R92: 4.7K; R_0603_1608Metric

Connections:
3.3V: R25.1, R28.1, R32.1, R37.1, R43.1, R57.1, R61.1, R62.1, R66.1, R67.1, R73.1, R74.1, R82.1, R83.1, R84.1, R85.1, R93.1, R94.1; also elsewhere on the board
GND: C40.2, C41.2, C42.2, C43.2, C44.2, C45.2, Q5.1 (S2), Q5.4 (S1), Q7.1 (S2), Q7.4 (S1), Q9.1 (S2), Q9.4 (S1), Q11.1 (S2), Q11.4 (S1), Q13.1 (S2), Q13.4 (S1), Q15.1 (S2), Q15.4 (S1); also elsewhere on the board
IMU_SCL: Q4.4 (E2), Q4.6 (C1), R66.2, R75.1, R97.1; also elsewhere on the board
IMU_SDA: Q6.4 (E2), Q6.6 (C1), R67.2, R76.1, R98.1; also elsewhere on the board
MISO: Q16.3 (C), Q17.3 (C), R50.2, R54.2; also elsewhere on the board
MOSI: R64.2, R70.1; also elsewhere on the board
unnamed: Q4.2 (B1), R71.1
unnamed: Q4.5 (B2), Q5.6 (D1), R61.2, R71.2
unnamed: Q5.2 (G2), Q5.3 (D2), R73.2
unnamed: C40.1, Q5.5 (G1), R75.2
unnamed: Q6.2 (B1), R72.1
unnamed: Q6.5 (B2), Q7.6 (D1), R62.2, R72.2
unnamed: Q7.2 (G2), Q7.3 (D2), R74.2
unnamed: C41.1, Q7.5 (G1), R76.2
unnamed: Q8.2 (B1), R86.1
unnamed: Q8.5 (B2), Q9.6 (D1), R82.2, R86.2
unnamed: Q9.2 (G2), Q9.3 (D2), R93.2
unnamed: C42.1, Q9.5 (G1), R95.2
unnamed: Q10.2 (B1), R87.1
unnamed: Q10.5 (B2), Q11.6 (D1), R83.2, R87.2
unnamed: Q11.2 (G2), Q11.3 (D2), R94.2
unnamed: C43.1, Q11.5 (G1), R96.2
unnamed: Q12.2 (B1), R27.1
unnamed: Q12.5 (B2), Q13.6 (D1), R27.2, R28.2
unnamed: Q13.2 (G2), Q13.3 (D2), R25.2
unnamed: C44.1, Q13.5 (G1), R33.2
unnamed: Q14.2 (B1), R38.1
unnamed: Q14.5 (B2), Q15.6 (D1), R38.2, R43.2
unnamed: Q15.2 (G2), Q15.3 (D2), R37.2
unnamed: C45.1, Q15.5 (G1), R58.2
unnamed: Q16.1 (B), R92.1
unnamed: Q16.2 (E), R53.1
unnamed: Q17.1 (B), R68.1
unnamed: Q17.2 (E), R99.1
PWR_SCL: Q8.4 (E2), Q8.6 (C1), R23.1, R84.2, R95.1; also elsewhere on the board
PWR_SDA: Q10.4 (E2), Q10.6 (C1), R44.1, R85.2, R96.1; also elsewhere on the board
RTC_SCL: Q12.4 (E2), Q12.6 (C1), R32.2, R33.1, R45.1; also elsewhere on the board
RTC_SDA: Q14.4 (E2), Q14.6 (C1), R48.1, R57.2, R58.1; also elsewhere on the board
SCK: R63.2, R69.2; also elsewhere on the board
SCL1: Q4.1 (E1), Q4.3 (C2), Q8.1 (E1), Q8.3 (C2), R23.2, R97.2; also elsewhere on the board
SCL3: Q12.1 (E1), Q12.3 (C2), R45.2; also elsewhere on the board
SDA1: Q6.1 (E1), Q6.3 (C2), Q10.1 (E1), Q10.3 (C2), R44.2, R98.2; also elsewhere on the board
SDA3: Q14.1 (E1), Q14.3 (C2), R48.2; also elsewhere on the board
SD_CS: R92.2; also elsewhere on the board
SD_MISO: R53.2, R54.1; also elsewhere on the board
SD_MOSI: R64.1; also elsewhere on the board
SD_SCK: R63.1; also elsewhere on the board
UHF_CS: R68.2; also elsewhere on the board
UHF_MISO: R50.1, R99.2; also elsewhere on the board
UHF_MOSI: R70.2; also elsewhere on the board
UHF_SCK: R69.1; also elsewhere on the board

Notes on the sheet:
I2C Bus Protection - RTC
I2C Bus Protection - Power Monitor & USB Charger
SPI Bus Protection - UHF Radio MCU
SPI Bus Protection - SD Card and Payloads
These novel bus protection circuits prevent traditional I2C/SPI failure modes where a single slave failure can disable the entire bus. Learn more: https://doi.org/10.36227/techrxiv.15166620 By default, slave clock and/or data lines can be held low and the Master (SAMD51) will still be able to commu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
NOTE
I2C Bus Protection - IMU
Bus Protection - Bypass Jumpers
NOTE: Components labeled "do not install" (DNI) are not populated by default
Bus Protection

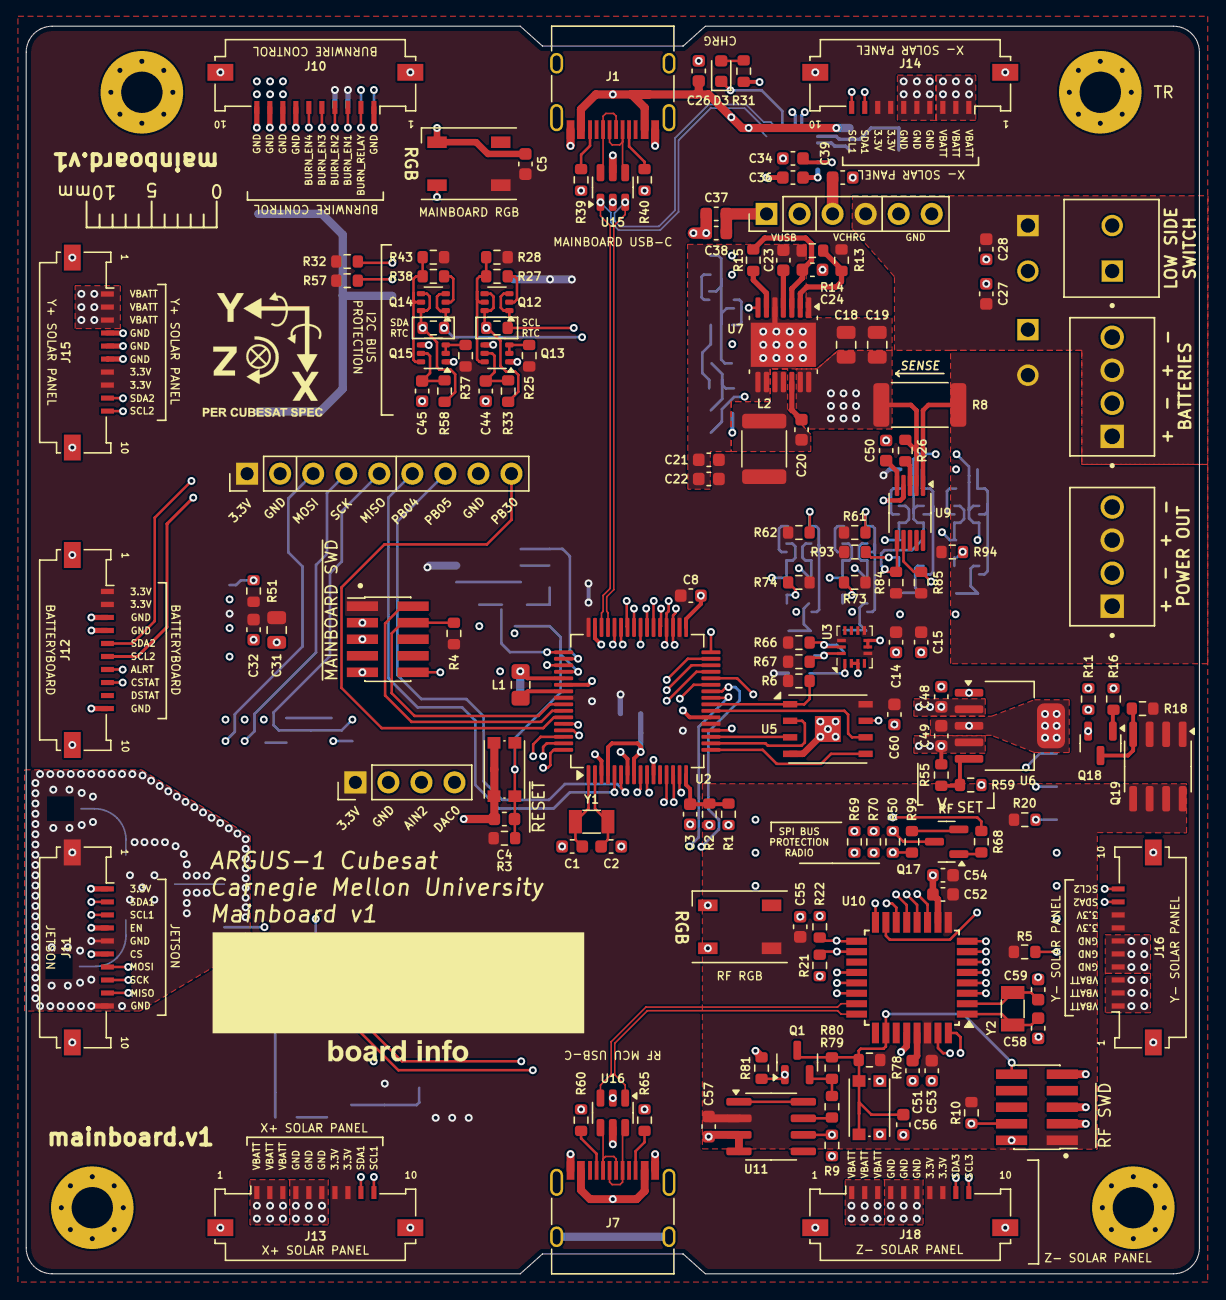
[picture p8: board Mainboard.kicad_pcb from above]

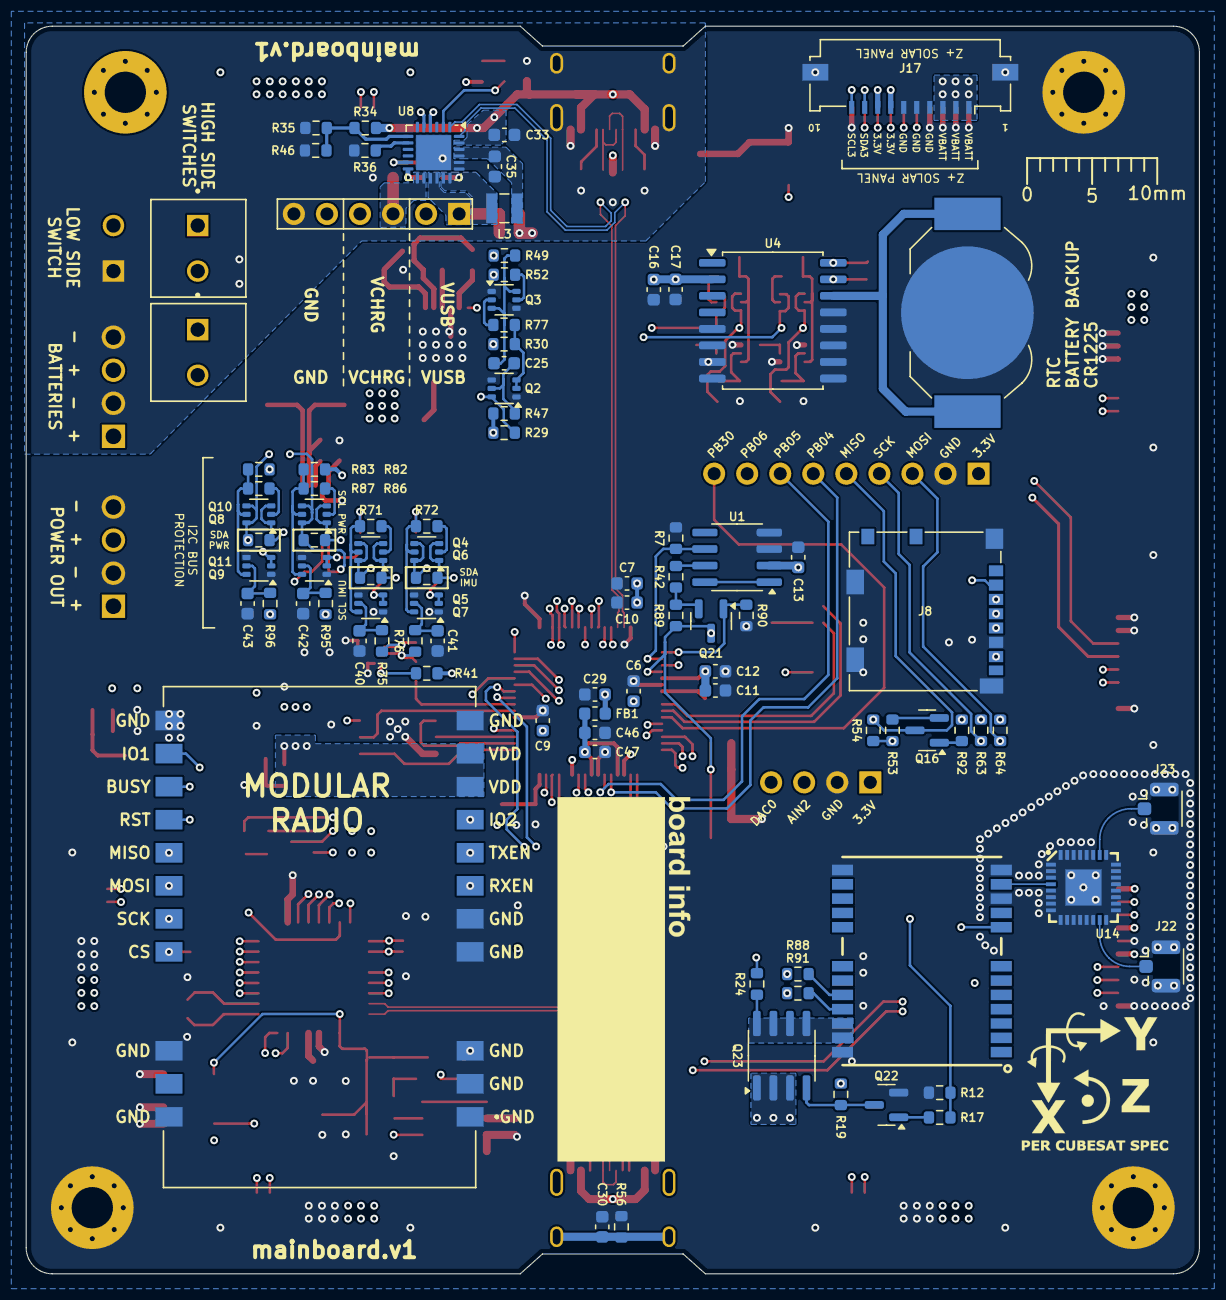
[picture p9: board Mainboard.kicad_pcb from below]

Board: 4 copper layers, 90.2 x 95.9 mm, 237 parts (90 on the bottom side), 178 nets.
