cmu-argus-1/Avionics-Mainboard/(commit log)

2024-06-28 Complete layout
    [Avionics.kicad_sch, Bus_Protection.kicad_sch, Connectors.kicad_sch, Mainboard.kicad_sch, Peripherals.kicad_sch, Power.kicad_sch, RF_and_GPS.kicad_sch]
2024-07-02 Updated Mounting Holes
    [Mainboard.kicad_pcb, Mainboard.kicad_sch]
2024-07-19 v1 Final
    [Avionics.kicad_sch, Bus_Protection.kicad_sch, Connectors.kicad_sch, Mainboard.kicad_pcb, Power.kicad_sch, RF_and_GPS.kicad_sch]
2024-09-10 Fixed/Added I2C addresses to schematic
    [Power.kicad_sch]
